car-hacking-village/DC32_CHV_Badge_Board/footprint/sponsor/aptiv.png

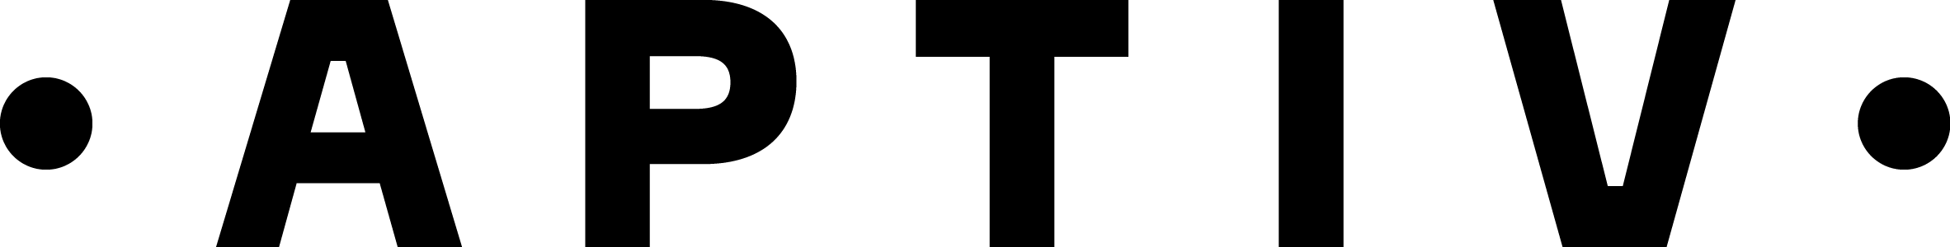
footprint/sponsor/aptiv.png
