car-hacking-village/DC32_CHV_Badge_Board/footprint/sponsor/block_harbor.png

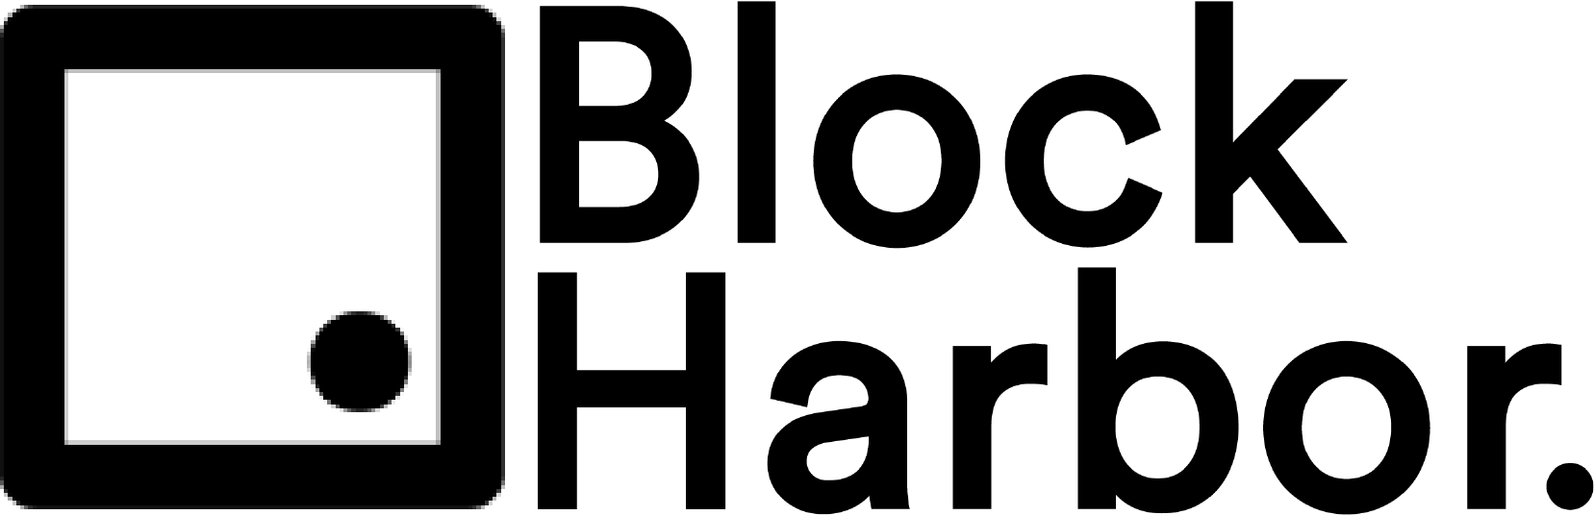
footprint/sponsor/block_harbor.png
