car-hacking-village/DC32_CHV_Badge_Board/footprint/sponsor/cartapillar.png

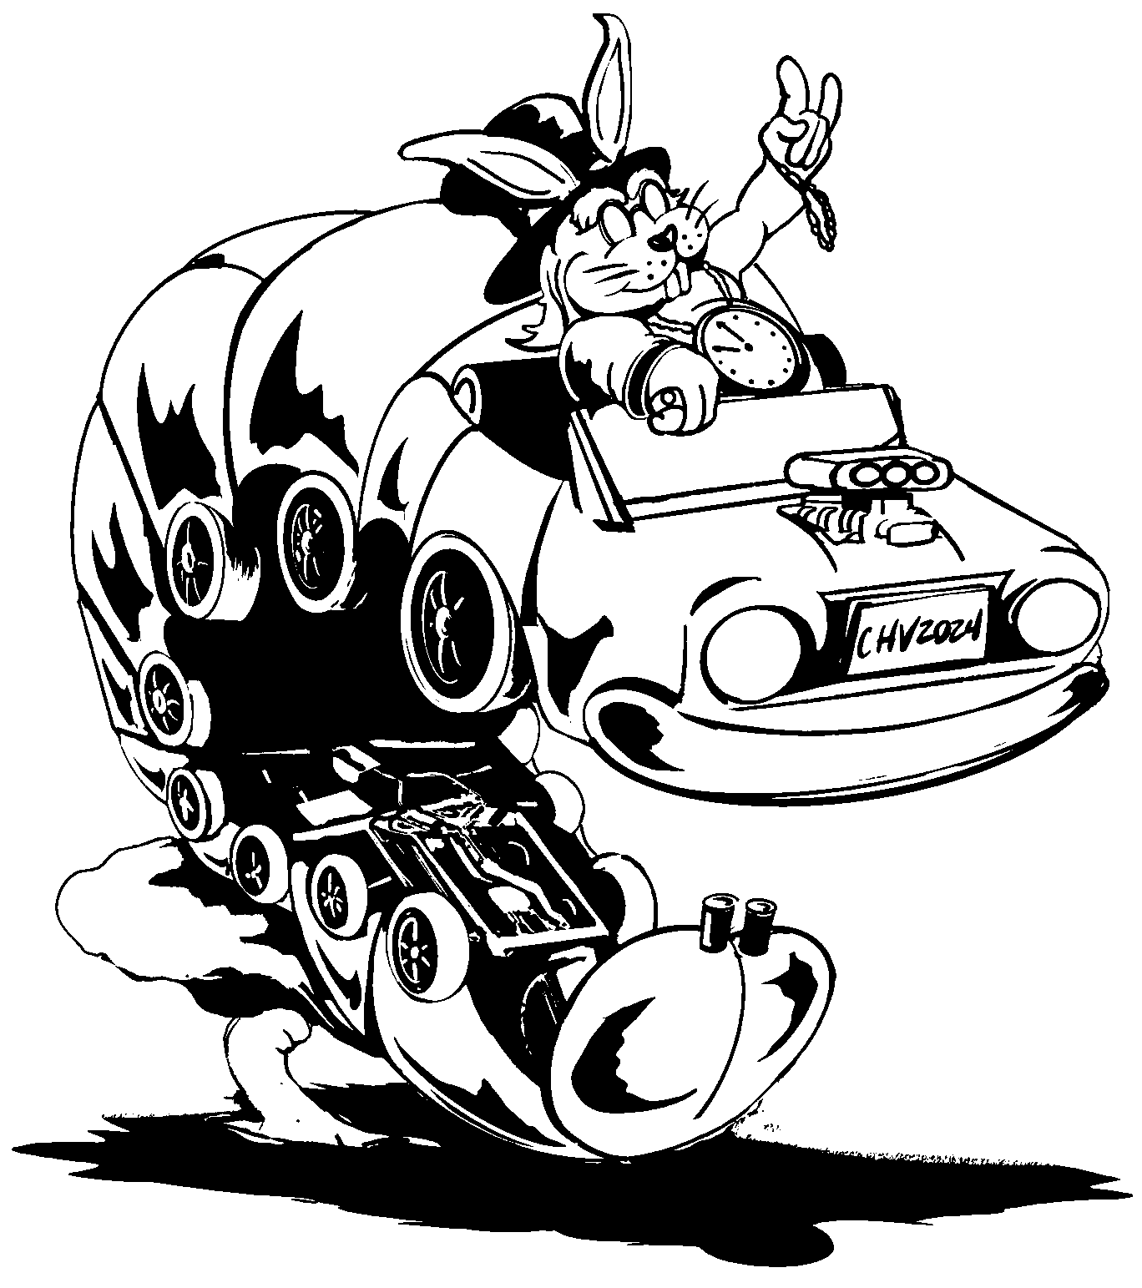
footprint/sponsor/cartapillar.png
