car-hacking-village/DC32_CHV_Badge_Board/footprint/sponsor/chv.png

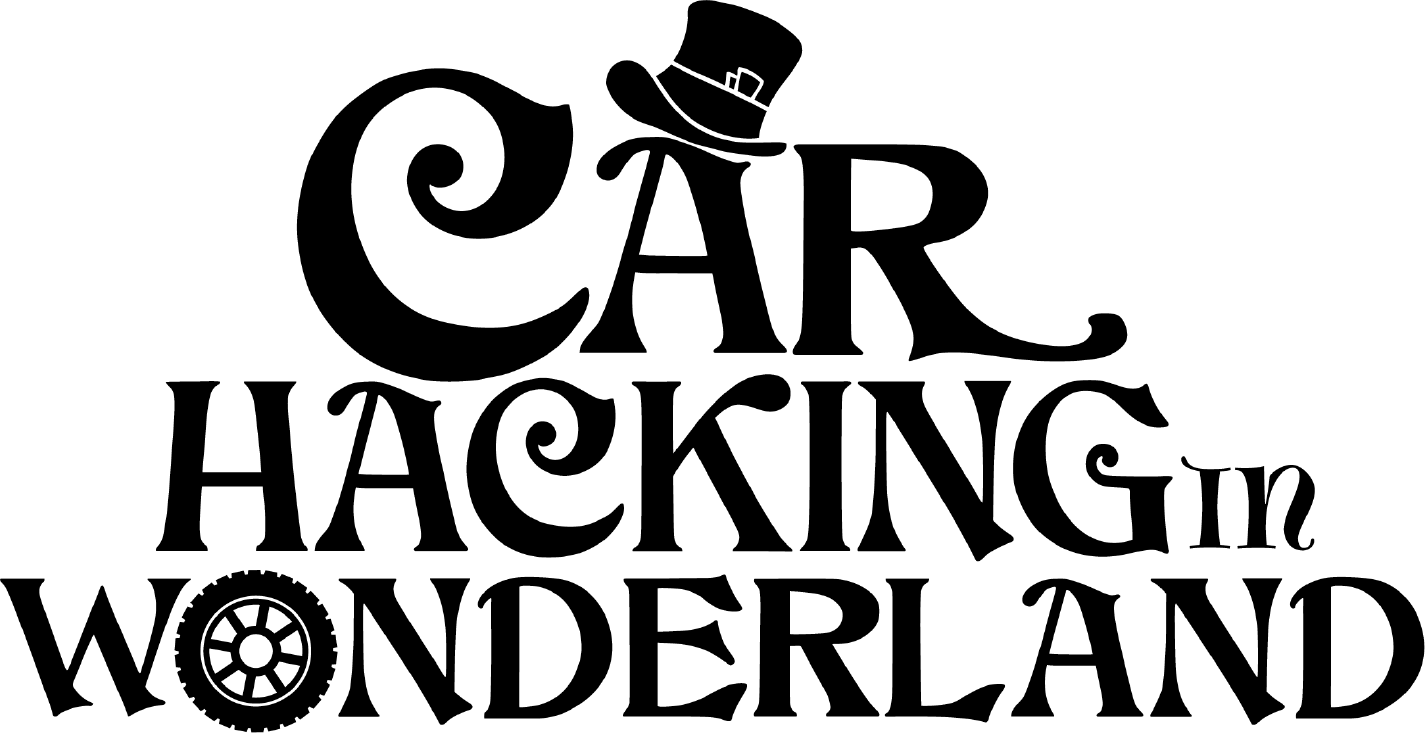
footprint/sponsor/chv.png
