car-hacking-village/DC32_CHV_Badge_Board/footprint/sponsor/ioactive.png

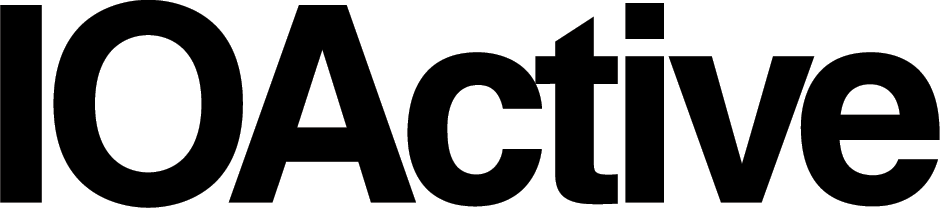
footprint/sponsor/ioactive.png
