car-hacking-village/DC32_CHV_Badge_Board/footprint/track/.svg2shenzhen-cache/images/F.Cu_g26.png

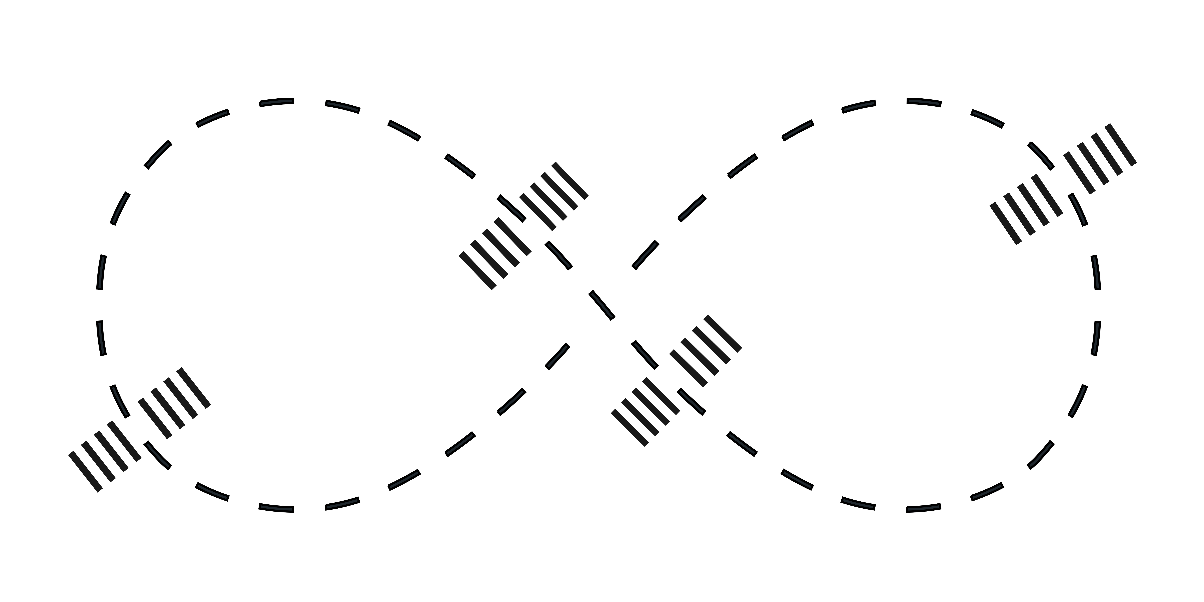
footprint/track/.svg2shenzhen-cache/images/F.Cu_g26.png
