car-hacking-village/DC32_CHV_Badge_Board/footprint/track/.svg2shenzhen-cache/images/F.SilkS_g28.png

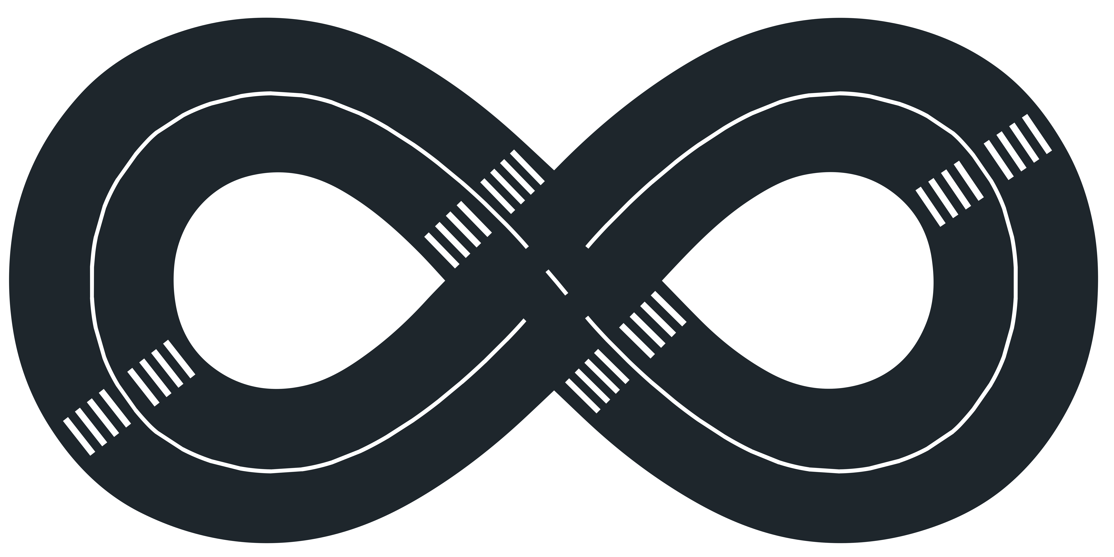
footprint/track/.svg2shenzhen-cache/images/F.SilkS_g28.png
