car-hacking-village/DC32_CHV_Badge_Board/CHV_DC32/CHV_MainBadge_D32_BOM_PCBWay.xlsx

 |  |  | xxxx xxxx xxxxx xxPCS BOM (Sample Bill of Materials)
Item # | *Designator | *Qty | Manufacturer | *Mfg Part # | Description / Value | *Package/Footprint | Type | Your Instructions / Notes | SMD
1 | BT1 | 1 | Keystone Electronics | 2462 | Battery | BatteryHolder_Keystone_2462_2xAA | Thru-hole |  | DNS
2 | C1,C2,C3,C6,C7,C8,C9,C10,C11,C12,C13,C15,C19,C21,C23 | 15 | HUI JU | NL0805B104M500CPBN | 100nF | 0805_2012Metric | SMD | Can be replaced | Thru-hole
3 | C4,C5 | 2 | CCTC | TCC0805X7R105M250FTF | 1uF | 0805_2012Metric | SMD | Can be replaced
4 | C16,C17 | 2 | CCTC | TCC0805COG120J500BT | 12pF | 0805_2012Metric | SMD | Can be replaced
5 | C27,C29,C30 | 3 | Murata Electronics | GRM188R60J106KME84D | GRM188R60J106KME84D | 0805_2012Metric | SMD | NOT replaceable
6 | C28 | 1 | TORCH | C0805B104K500NT | 0.1uF, X7R ceramic | 0805_2012Metric | SMD | Can be replaced
7 | D1 | 1 | HXY MOSFET | SD103AW | D_Schottky | SOD-123 | SMD | Can be replaced
8 | D2,D3,D4,D5,D6,D7,D8,D9,D10,D11,D12,D13,D14,D15,D16,D17,D18,D19,D20,D21,D22,D23,D24,D25,D26,D27,D28,D29,D30,D31,D32,D33,D34,D35,D36,D37,D38,D39,D40,D41,D42 | 41 | TUOZHAN | F.1206.00017/P2-1206W6YS1-09T-001 | LED | 1206_3216Metric | SMD
9 | IC1 | 1 | Winbond Elec | W25Q16JVUXIQ | W25Q16JVUXIQ_TR | SON50P300X200X60-9N | SMD
10 | J3,J4,J5,J7 | 4 | Sullins Connector Solutions | SFH11-NBPC-D03-ST-BK | Conn_02x03_Odd_Even | PinHeader_2x03_P2.54mm_Vertical | Thru-hole
11 | J6 | 1 | MAX | MX128-2.54-GN01-03P-Cu-Y-A | Conn_01x03 | PinHeader_1x03_P2.54mm_Vertical | Thru-hole
12 | J8 | 1 | Korean Hroparts Elec | TYPE-C-31-M-12 | USB_C_Receptacle_USB2.0_16P | USB_C_Receptacle_HRO_TYPE-C-31-M-12 | SMD
13 | L2 | 1 | Coilcraft | LPS3010 | LPS3015-152MRC | L_Coilcraft_LPS3010 | SMD
14 | Q1 | 1 | HXY MOSFET | SI2301-ZE | PMOS | SOT-23 | SMD
15 | R1,R28 | 2 | Sunway | SC0805J1200F4ANRH | 120 | R_0805_2012Metric | SMD | Can be replaced
16 | R2,R7,R10,R12,R24,R26,R59 | 7 | Sunway | SC0805J1002F4ANRH | 10k | R_0805_2012Metric | SMD | Can be replaced
17 | R3,R4 | 2 | Sunway | SC0805J5101F4ANRH | 5.1k | R_0805_2012Metric | SMD | Can be replaced
18 | R5,R6 | 2 | VO | SCR0805J27R | 27 | R_0805_2012Metric | SMD | Can be replaced
19 | R8,R13,R15,R16,R17,R18,R19,R20,R21,R22,R23,R25,R27,R32,R33,R34,R35,R36,R37,R38,R39,R40,R41,R42,R43,R44,R45,R46,R47,R48,R49,R50,R51,R52,R53,R54,R55,R56,R57,R58,R60 | 41 | UNI-ROYAL(Uniroyal Elec) | 0805W8F1002T5E | 110 | R_0805_2012Metric | SMD | Can be replaced
20 | R9 | 1 | VO | SCR0805J1K | 1k | R_0805_2012Metric | SMD | Can be replaced
21 | R14 | 1 | Sunway | SC0805J1003F4ANRH | 100k | R_0805_2012Metric | SMD | Can be replaced
22 | S1,S5,S6,S7,S8,S9 | 6 | G-Switch | MK-12C02-G020 | MK-12C02-G020 | MK12C02G020 | SMD
23 | S2,S3 | 2 | Omron Electronics | B3SL-1022P | Single Pole Single Throw (SPST) button | SW_SPST_B3SL-1022P | SMD
24 | SW1 | 1 | HanElectricity | SS-12D07G4 | SW_SPDT | SW_Slide_SPDT_Straight_CK_OS102011MS2Q | Thru-hole
25 | U1,U4,U6,U7,U8 | 5 | Texas Instruments | SN65HVD230 | SN65HVD230 | SOIC-8_3.9x4.9mm_P1.27mm | SMD
26 | U2 | 1 | RASPBERRY-PI | RP2040TR7 | RP2040 | RP2040-QFN-56 | SMD
27 | U5 | 1 | Texas Instruments | TPS63031DSK | TPS63031DSK | WSON-10-1EP_2.5x2.5mm_P0.5mm_EP1.2x2mm | SMD
28 | Y1 | 1 | TAITIEN Elec | XYDBPCNANF-12MHZ | XYDBPCNANF-12MHz | Crystal_XYDBPCNANF-12MHZ | SMD
