car-hacking-village/DC32_CHV_Badge_Board/(commit log)

2024-04-14 more updates
    [CHV_DC32.kicad_sch]
2024-04-22 finished schematic
    [CHV_DC32.kicad_sch]
2024-04-28 getting closer
    [CHV_DC32.kicad_pcb]
2024-05-04 design got simplified!
    [CHV_DC32.kicad_pcb, CHV_DC32.kicad_sch]
2024-05-05 getting so close
    [CHV_DC32.kicad_pcb, CHV_DC32.kicad_sch]
2024-05-13 changed leds to single color and placed them around the track
    [CHV_DC32.kicad_pcb, CHV_DC32.kicad_sch]
2024-06-01 Initial revision complete
    [CHV_DC32-B_Cu.gbr, CHV_DC32-B_Mask.gbr, CHV_DC32-B_Paste.gbr, CHV_DC32-B_Silkscreen.gbr, CHV_DC32-Edge_Cuts.gbr, CHV_DC32-F_Cu.gbr, CHV_DC32-F_Mask.gbr, CHV_DC32-F_Paste.gbr]
2024-06-18 fixed major issue where pins were left floating
    [CHV_DC32.kicad_pcb, CHV_DC32.kicad_sch]
2024-06-19 fixed badge footprint
    [CHV_DC32.kicad_pcb]
2024-06-19 small update to track
2024-06-19 updated track
2024-06-21 added sponsors
    [CHV_DC32-B_Cu.gbr, CHV_DC32-B_Mask.gbr, CHV_DC32-B_Paste.gbr, CHV_DC32-B_Silkscreen.gbr, CHV_DC32-Edge_Cuts.gbr, CHV_DC32-F_Cu.gbr, CHV_DC32-F_Mask.gbr, CHV_DC32-F_Paste.gbr]
2024-06-21 changed logo sizes
    [CHV_DC32.kicad_pcb]
2024-06-21 added more logos
    [CHV_DC32-B_Cu.gbr, CHV_DC32-B_Mask.gbr, CHV_DC32-B_Paste.gbr, CHV_DC32-B_Silkscreen.gbr, CHV_DC32-Edge_Cuts.gbr, CHV_DC32-F_Cu.gbr, CHV_DC32-F_Mask.gbr, CHV_DC32-F_Paste.gbr]
